Ken-2511/motion-light-switch/slave/motion-light-switch-slave.kicad_pcb

## KiCad design slave/motion-light-switch-slave.kicad_pcb (2026-11-13)

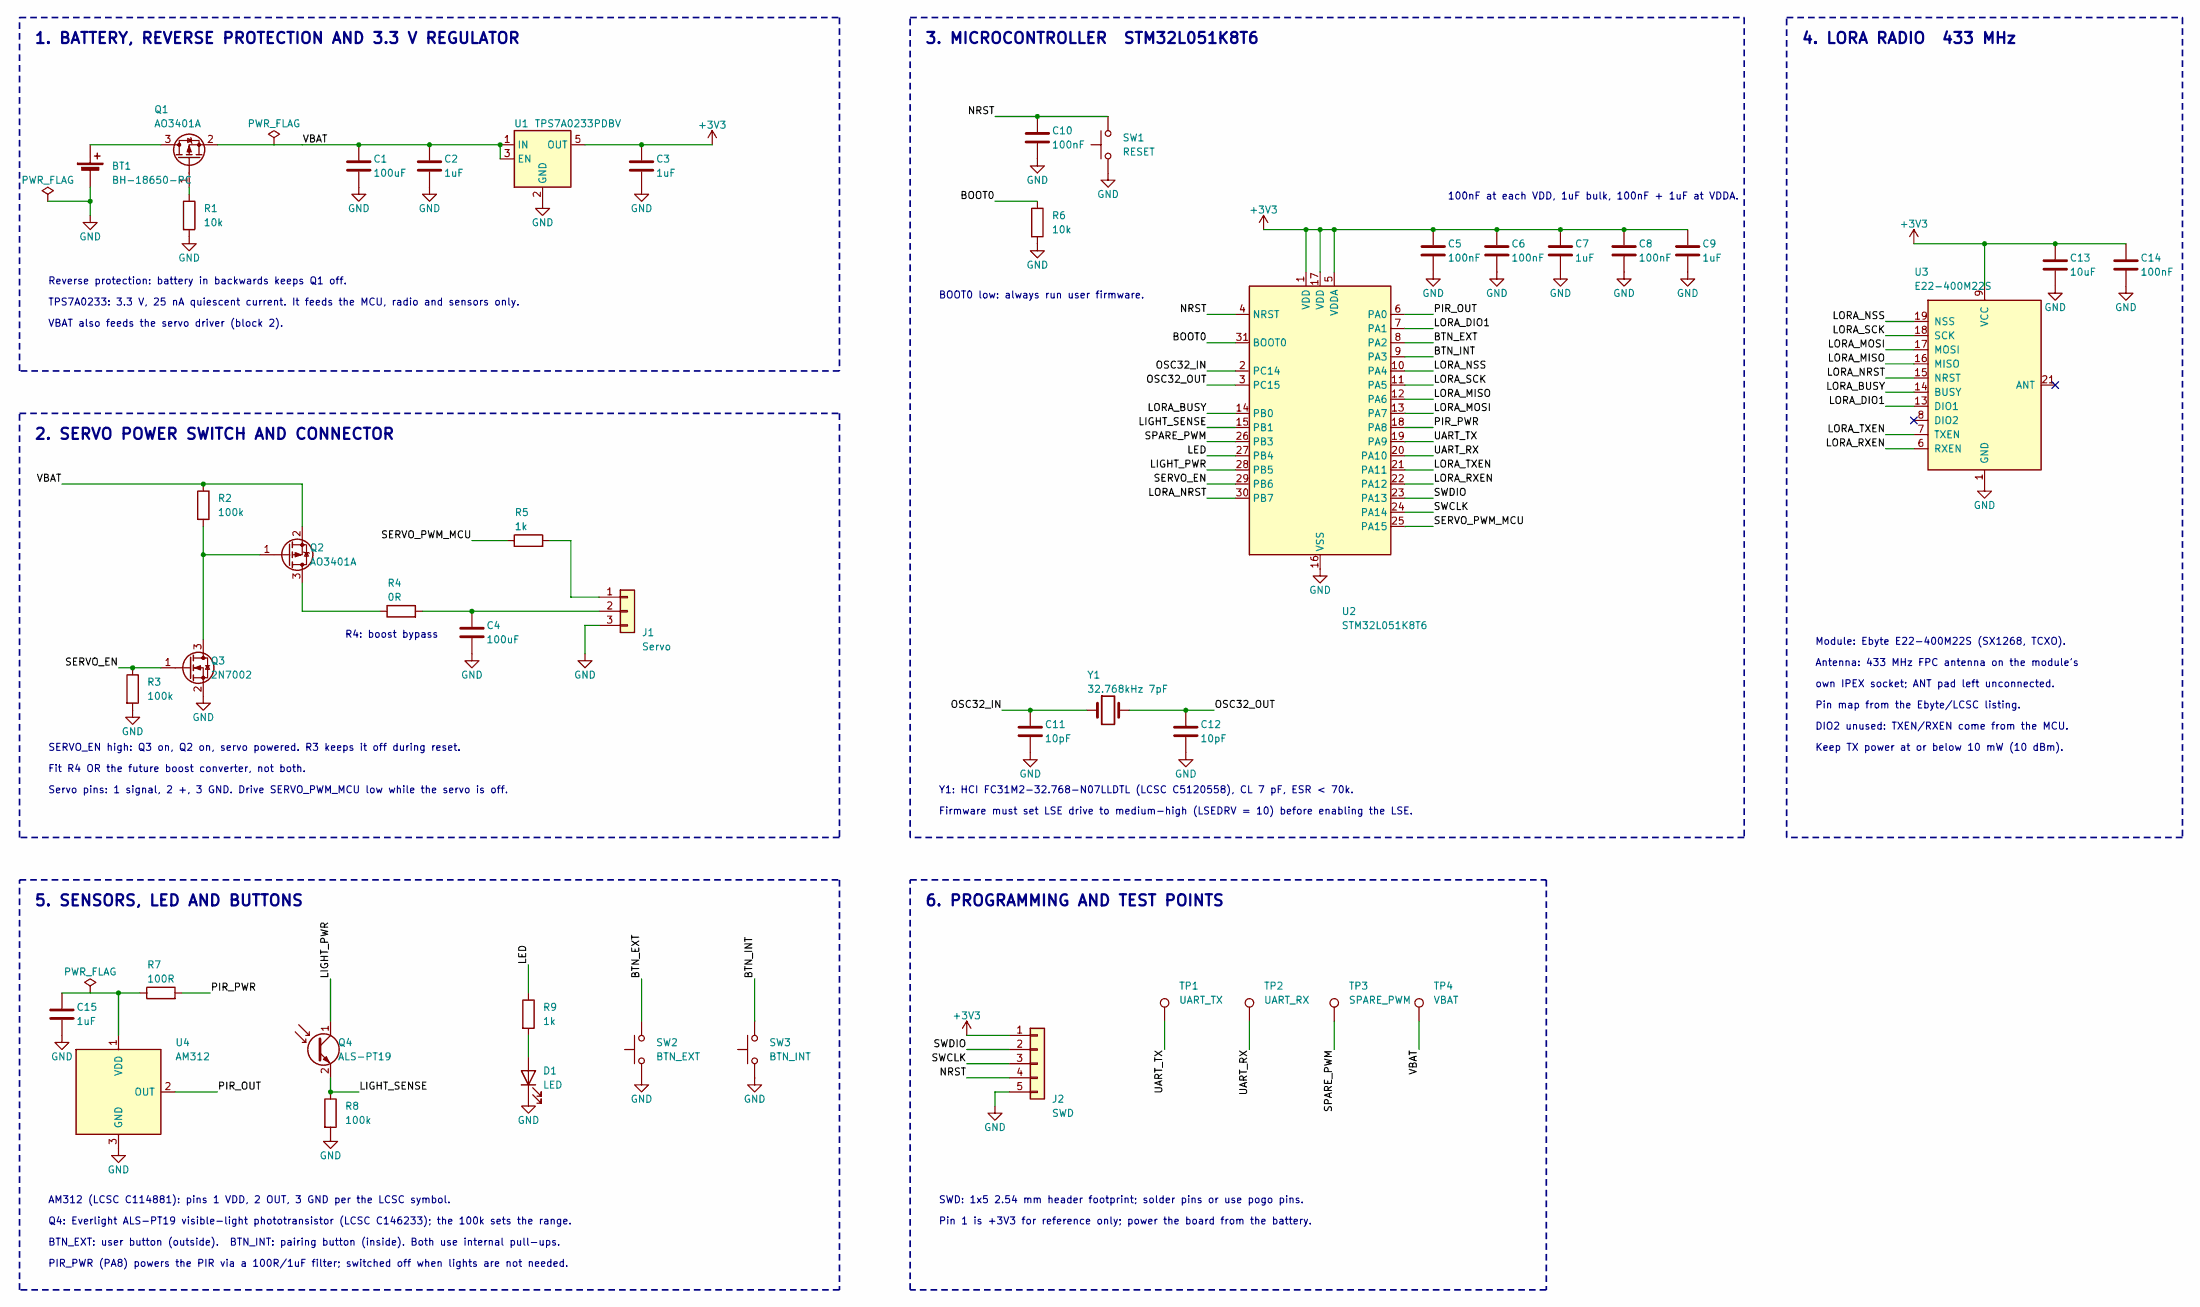
[picture p1: schematic motion-light-switch-slave.kicad_sch, Motion Light Switch - Slave]

Parts:
BT1: BH-18650-PC; BatteryHolder_MPD_BH-18650-PC
C1, C4: 100uF; C_1206_3216Metric
C2, C3, C7, C9, C15: 1uF; C_0603_1608Metric
C5, C6, C8, C10, C14: 100nF; C_0603_1608Metric
C11, C12: 10pF; C_0603_1608Metric
C13: 10uF; C_0805_2012Metric
D1: LED; LED_0603_1608Metric
J1: Servo; PinHeader_1x03_P2.54mm_Vertical
J2: SWD; PinHeader_1x05_P2.54mm_Vertical
Q1, Q2: AO3401A; SOT-23
Q3: 2N7002; SOT-23
Q4: ALS-PT19
R1, R6: 10k; R_0603_1608Metric
R2, R3, R8: 100k; R_0603_1608Metric
R4: 0R; R_0603_1608Metric
R5, R9: 1k; R_0603_1608Metric
R7: 100R; R_0603_1608Metric
SW1: RESET; SW_SPST_TL3342
SW2: BTN_EXT; SW_SPST_TL3342
SW3: BTN_INT; SW_SPST_TL3342
TP1: UART_TX; TestPoint_Pad_D1.0mm
TP2: UART_RX; TestPoint_Pad_D1.0mm
TP3: SPARE_PWM; TestPoint_Pad_D1.0mm
TP4: VBAT; TestPoint_Pad_D1.0mm
U1: TPS7A0233PDBV; SOT-23-5
U2: STM32L051K8T6; LQFP-32_7x7mm_P0.8mm
U3: E22-400M22S
U4: AM312; AM312_TO-5-3
Y1: 32.768kHz 7pF; Crystal_SMD_3215-2Pin_3.2x1.5mm

Connections:
+3V3: C3.1, C5.1, C6.1, C7.1, C8.1, C9.1, C13.1, C14.1, J2.1, U1.5 (OUT), U2.1 (VDD), U2.5 (VDDA), U2.17 (VDD), U3.9 (VCC)
/BOOT0: R6.1, U2.31 (BOOT0)
/BTN_EXT: SW2.2, U2.8 (PA2)
/BTN_INT: SW3.2, U2.9 (PA3)
/LED: R9.1, U2.27 (PB4)
/LIGHT_PWR: Q4.1 (C), U2.28 (PB5)
/LIGHT_SENSE: Q4.2 (E), R8.1, U2.15 (PB1)
/LORA_BUSY: U2.14 (PB0), U3.14 (BUSY)
/LORA_DIO1: U2.7 (PA1), U3.13 (DIO1)
/LORA_MISO: U2.12 (PA6), U3.16 (MISO)
/LORA_MOSI: U2.13 (PA7), U3.17 (MOSI)
/LORA_NRST: U2.30 (PB7), U3.15 (NRST)
/LORA_NSS: U2.10 (PA4), U3.19 (NSS)
/LORA_RXEN: U2.22 (PA12), U3.6 (RXEN)
/LORA_SCK: U2.11 (PA5), U3.18 (SCK)
/LORA_TXEN: U2.21 (PA11), U3.7 (TXEN)
/NRST: C10.1, J2.4, SW1.2, U2.4 (NRST)
/OSC32_IN: C11.1, U2.2 (PC14), Y1.1
/OSC32_OUT: C12.1, U2.3 (PC15), Y1.2
/PIR_OUT: U2.6 (PA0), U4.2 (OUT)
/PIR_PWR: R7.2, U2.18 (PA8)
/SERVO_EN: Q3.1 (G), R3.1, U2.29 (PB6)
/SERVO_PWM_MCU: R5.1, U2.25 (PA15)
/SPARE_PWM: TP3.1, U2.26 (PB3)
/SWCLK: J2.3, U2.24 (PA14)
/SWDIO: J2.2, U2.23 (PA13)
/UART_RX: TP2.1, U2.20 (PA10)
/UART_TX: TP1.1, U2.19 (PA9)
/VBAT: C1.1, C2.1, Q1.2 (S), Q2.2 (S), R2.1, TP4.1, U1.1 (IN), U1.3 (EN)
GND: BT1.2 (-), C1.2, C2.2, C3.2, C4.2, C5.2, C6.2, C7.2, C8.2, C9.2, C10.2, C11.2, C12.2, C13.2, C14.2, C15.2, D1.1 (K), J1.3, J2.5, Q3.2 (S), R1.2, R3.2, R6.2, R8.2, SW1.1, SW2.1, SW3.1, U1.2 (GND), U2.16 (VSS), U2.32 (VSS), U3.1 (GND), U3.2 (GND), U3.3 (GND), U3.4 (GND), U3.5 (GND), U3.10 (GND), U3.11 (GND), U3.12 (GND), U3.20 (GND), U3.22 (GND), U4.3 (GND)
unnamed: BT1.1 (+), Q1.3 (D)
unnamed: D1.2 (A), R9.2
unnamed: J1.1, R5.2
unnamed: C4.1, J1.2, R4.2
unnamed: Q1.1 (G), R1.1
unnamed: Q2.3 (D), R4.1
unnamed: Q2.1 (G), Q3.3 (D), R2.2
unnamed: C15.1, R7.1, U4.1 (VDD)

Notes on the sheet:
1. BATTERY, REVERSE PROTECTION AND 3.3 V REGULATOR
Reverse protection: battery in backwards keeps Q1 off.
TPS7A0233: 3.3 V, 25 nA quiescent current. It feeds the MCU, radio and sensors only.
VBAT also feeds the servo driver (block 2).
2. SERVO POWER SWITCH AND CONNECTOR
R4: boost bypass
SERVO_EN high: Q3 on, Q2 on, servo powered. R3 keeps it off during reset.
Fit R4 OR the future boost converter, not both.
Servo pins: 1 signal, 2 +, 3 GND. Drive SERVO_PWM_MCU low while the servo is off.
3. MICROCONTROLLER STM32L051K8T6
100nF at each VDD, 1uF bulk, 100nF + 1uF at VDDA.
BOOT0 low: always run user firmware.
Y1: HCI FC31M2-32.768-N07LLDTL (LCSC C5120558), CL 7 pF, ESR < 70k.
Firmware must set LSE drive to medium-high (LSEDRV = 10) before enabling the LSE.
4. LORA RADIO 433 MHz
Module: Ebyte E22-400M22S (SX1268, TCXO).
Antenna: 433 MHz FPC antenna on the module's
own IPEX socket; ANT pad left unconnected.
Pin map from the Ebyte/LCSC listing.
DIO2 unused: TXEN/RXEN come from the MCU.
Keep TX power at or below 10 mW (10 dBm).
5. SENSORS, LED AND BUTTONS
AM312 (LCSC C114881): pins 1 VDD, 2 OUT, 3 GND per the LCSC symbol.
Q4: Everlight ALS-PT19 visible-light phototransistor (LCSC C146233); the 100k sets the range.
BTN_EXT: user button (outside). BTN_INT: pairing button (inside). Both use internal pull-ups.
PIR_PWR (PA8) powers the PIR via a 100R/1uF filter; switched off when lights are not needed.
6. PROGRAMMING AND TEST POINTS
SWD: 1x5 2.54 mm header footprint; solder pins or use pogo pins.
Pin 1 is +3V3 for reference only; power the board from the battery.

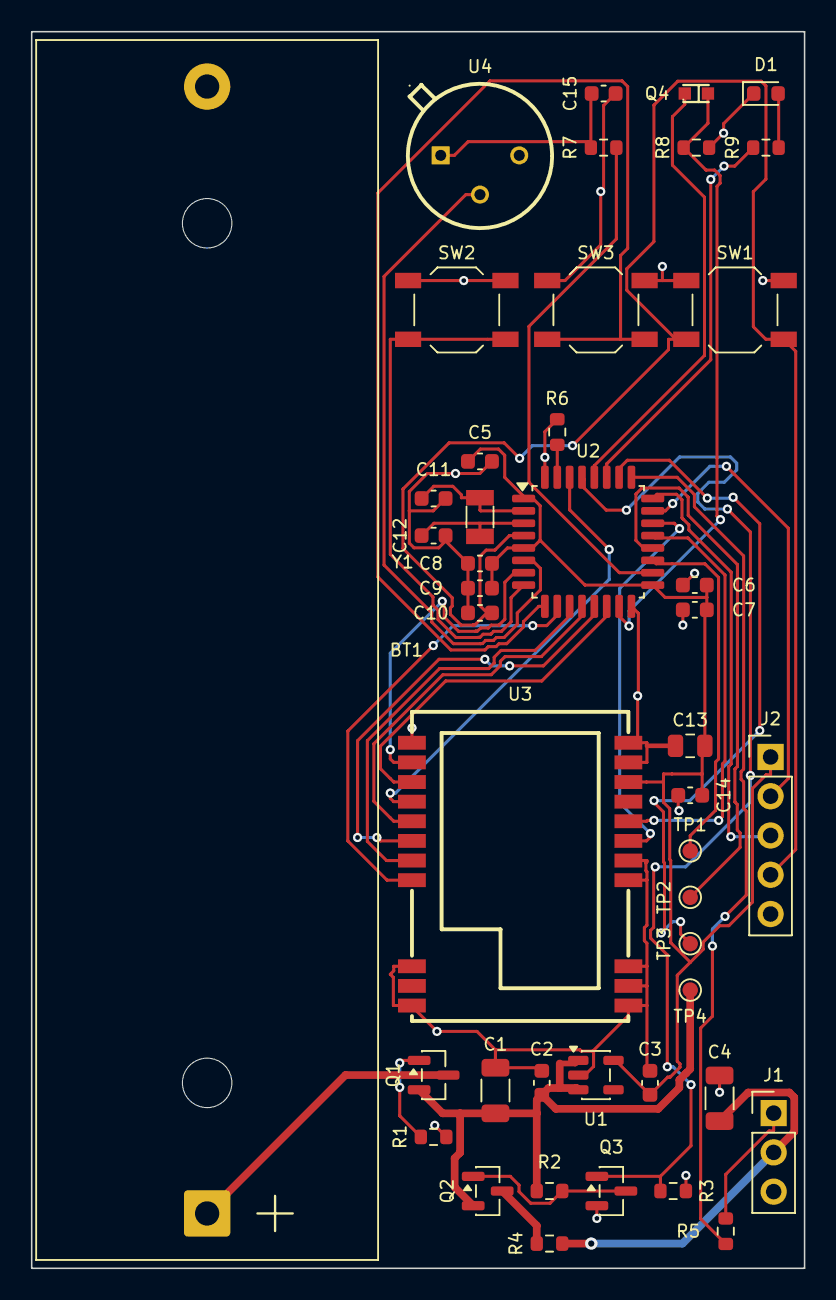
[picture p2: board motion-light-switch-slave.kicad_pcb from above]

Board: 2 copper layers, 50.0 x 80.0 mm, 44 parts (0 on the bottom side), 38 nets.
