Ken-2511/motion-light-switch/master/motion-light-switch-master.kicad_pcb

## KiCad design master/motion-light-switch-master.kicad_pcb (2026-11-13)

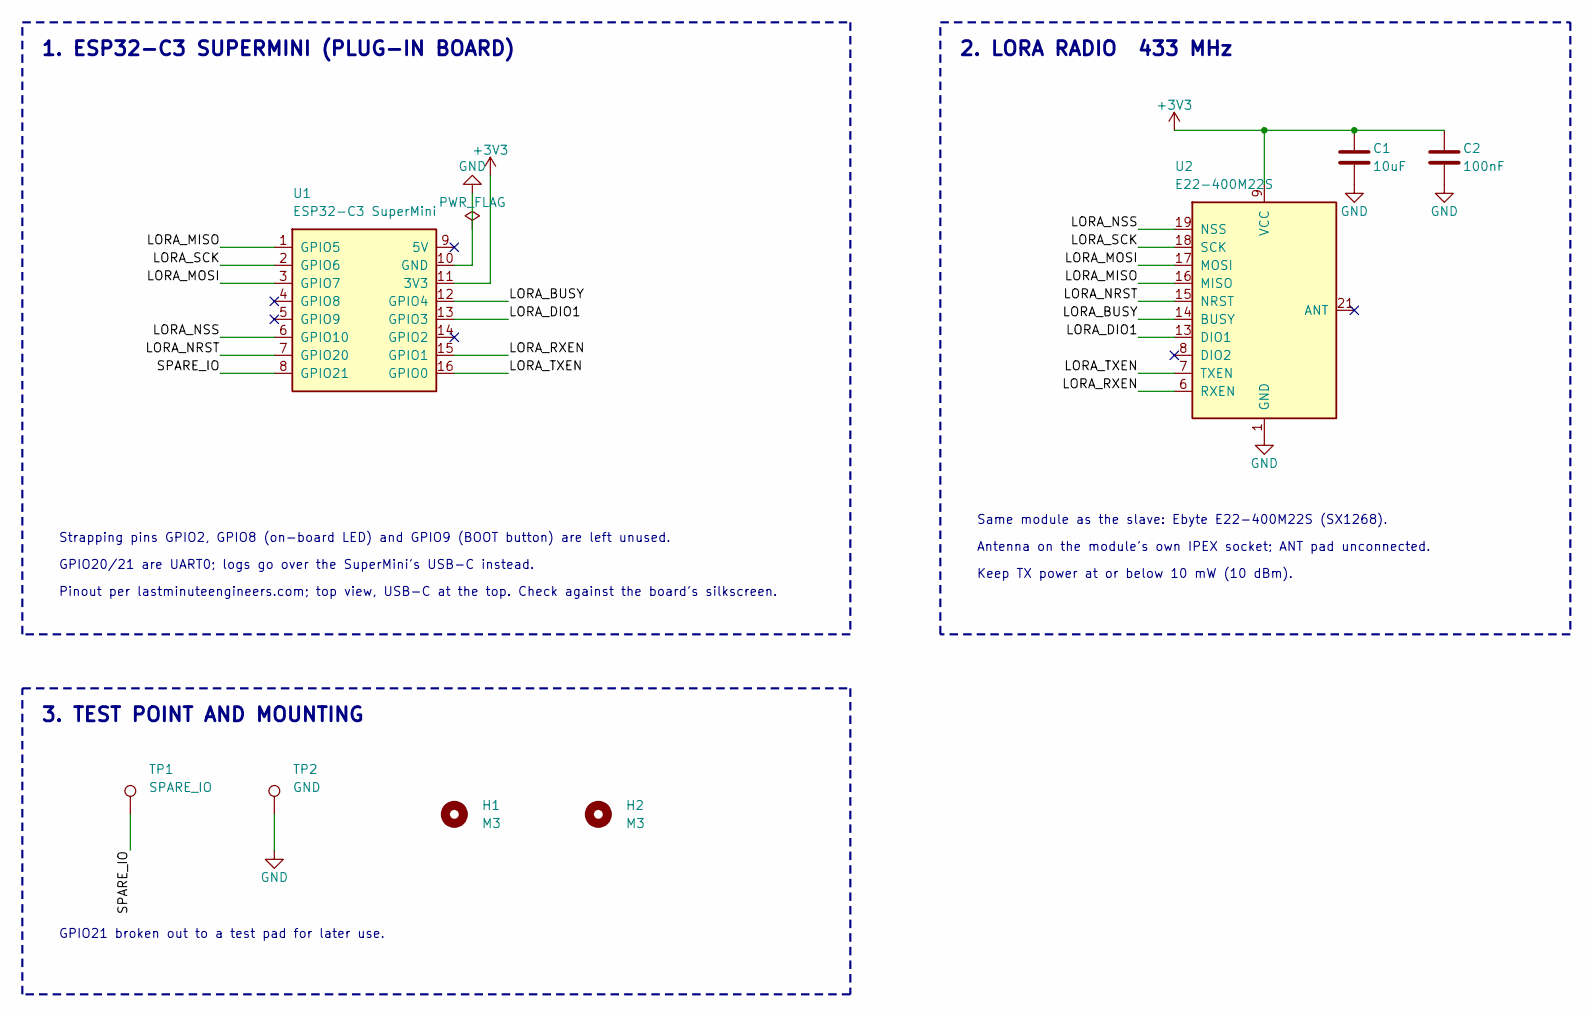
[picture p3: schematic motion-light-switch-master.kicad_sch, Motion Light Switch - Master]

Parts:
C1: 10uF; C_0805_2012Metric
C2: 100nF; C_0603_1608Metric
H1, H2: M3; MountingHole_3.2mm_M3
TP1: SPARE_IO; TestPoint_Pad_D1.0mm
TP2: GND; TestPoint_Pad_D1.0mm
U1: ESP32-C3 SuperMini; ESP32-C3_SuperMini_Socket
U2: E22-400M22S

Connections:
+3V3: C1.1, C2.1, U1.11 (3V3), U2.9 (VCC)
/LORA_BUSY: U1.12 (GPIO4), U2.14 (BUSY)
/LORA_DIO1: U1.13 (GPIO3), U2.13 (DIO1)
/LORA_MISO: U1.1 (GPIO5), U2.16 (MISO)
/LORA_MOSI: U1.3 (GPIO7), U2.17 (MOSI)
/LORA_NRST: U1.7 (GPIO20), U2.15 (NRST)
/LORA_NSS: U1.6 (GPIO10), U2.19 (NSS)
/LORA_RXEN: U1.15 (GPIO1), U2.6 (RXEN)
/LORA_SCK: U1.2 (GPIO6), U2.18 (SCK)
/LORA_TXEN: U1.16 (GPIO0), U2.7 (TXEN)
/SPARE_IO: TP1.1, U1.8 (GPIO21)
GND: C1.2, C2.2, TP2.1, U1.10 (GND), U2.1 (GND), U2.2 (GND), U2.3 (GND), U2.4 (GND), U2.5 (GND), U2.10 (GND), U2.11 (GND), U2.12 (GND), U2.20 (GND), U2.22 (GND)

Notes on the sheet:
1. ESP32-C3 SUPERMINI (PLUG-IN BOARD)
Strapping pins GPIO2, GPIO8 (on-board LED) and GPIO9 (BOOT button) are left unused.
GPIO20/21 are UART0; logs go over the SuperMini's USB-C instead.
Pinout per lastminuteengineers.com; top view, USB-C at the top. Check against the board's silkscreen.
2. LORA RADIO 433 MHz
Same module as the slave: Ebyte E22-400M22S (SX1268).
Antenna on the module's own IPEX socket; ANT pad unconnected.
Keep TX power at or below 10 mW (10 dBm).
3. TEST POINT AND MOUNTING
GPIO21 broken out to a test pad for later use.

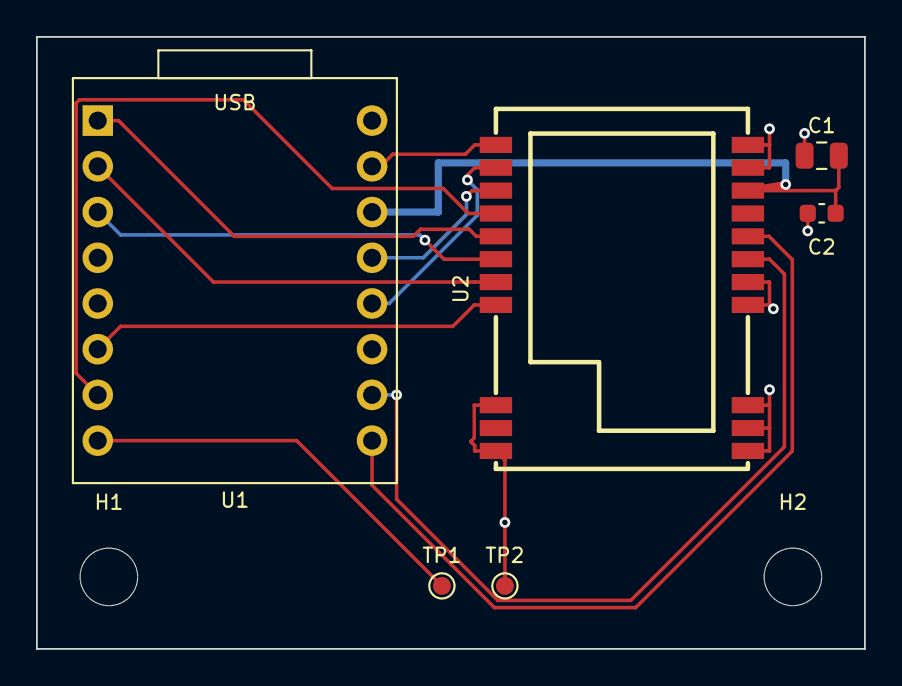
[picture p4: board motion-light-switch-master.kicad_pcb from above]

Board: 2 copper layers, 46.0 x 34.0 mm, 8 parts (0 on the bottom side), 12 nets.
