Ken-2511/motion-light-switch/(commit log)

2026-11-09 Record MCU, radio and LoRa band decisions in README
    Slave: STM32L051 with a 433 MHz SX1268 module. Master: ESP32-C3
    SuperMini hand-wired to a 433 MHz SX1268 module. Plain LoRa with
    SX1268 duty-cycled listening (~1 s) so the master can reach any
    slave. Drop suggestions that only applied to an ESP32 slave.
2026-11-09 Add KiCad project files
    [motion-light-switch.kicad_pcb, motion-light-switch.kicad_sch]
2026-11-09 Stop tracking KiCad local settings file and add .gitignore
2026-11-09 Record slave power, sensor and pin decisions; restructure README
    Add the AM312 PIR, phototransistor, TPS7A0233 LDO, AO3401
    reverse-polarity protection, servo power switch, VREFINT battery
    monitoring, and the STM32L051K8T6 pin assignment checked against the
    datasheet. Merge duplicate sections, drop resolved questions and
    suggestions, and redo the battery estimate for the STM32L0 design.
2026-11-12 Draw slave schematic; add crystal and switchable PIR power
    Slave schematic in six wired blocks (power, servo switch, MCU, LoRa
    radio, sensors, programming), ERC clean. Project symbol library adds
    E22-400M22S, AM312 and TPS7A0233PDBV. Fit the HCI FC31M2 32.768 kHz
    crystal (medium-high LSE drive) and power the PIR from PA8 through a
    100R/1uF filter. README updated to match.
    [motion-light-switch.kicad_sch]
2026-11-12 Use the E22-400M22S's own IPEX antenna socket
    Remove the separate antenna connector from the slave schematic and
    leave the module's ANT pad unconnected. README names the
    E22-400M22S for both master and slave.
    [motion-light-switch.kicad_sch]
2026-11-12 Assign footprints to all slave parts
    Add a project footprint library with E22-400M22S, AM312 (TO-5) and
    ALS-PT19 footprints converted from LCSC data. Use 2.54 mm headers for
    the servo and SWD connectors and the MPD BH-18650-PC footprint for
    the Taobao 18650 holder. Choose the visible-light ALS-PT19 for
    ambient light. README updated to match.
    [motion-light-switch.kicad_sch]
2026-11-13 Place and autoroute the slave PCB
    50x80 mm two-layer board: 18650 holder along the left edge, all parts
    on the front, GND pour on the back. Routed with Freerouting 2.5.0;
    0.5 mm Power net class for the battery/servo path, keep-out under the
    E22-400M22S, edge clearance 0.3 mm. DRC clean except cosmetic
    warnings. Also fix the AM312 courtyard and exclude test points from
    the BOM.
    [motion-light-switch.kicad_pcb, motion-light-switch.kicad_sch]
2026-11-13 Re-place and reroute the slave PCB for a solid ground plane
    Move the radio module next to the MCU and the regulator/servo switch
    next to the battery + terminal; put each decoupling capacitor at its
    pin and the crystal at PC14/PC15. Autoroute with high back-layer and
    via costs so B.Cu stays an almost unbroken GND pour, hand-route the
    servo supply link, and set the pour clearance to 0.2 mm. DRC clean
    apart from silkscreen warnings.
    [motion-light-switch.kicad_pcb]
2026-11-13 Tidy slave PCB silkscreen labels
    Shrink reference labels to 0.8 mm and place each one clear of pads,
    other silkscreen and other labels. Only the ALS-PT19 footprint's own
    outline still touches its pad.
    [motion-light-switch.kicad_pcb]
2026-11-13 Add master carrier board project
    New KiCad project in master/: ESP32-C3 SuperMini on two 1x8 sockets
    plus an E22-400M22S on a 46x34 mm board with two M3 holes. Radio on
    GPIO6/7/5 (SPI), GPIO10 NSS, GPIO4 BUSY, GPIO3 DIO1, GPIO20 NRST,
    GPIO0/1 TXEN/RXEN; strapping pins unused, GPIO21 on a test pad.
    Shared libraries gain a SuperMini symbol and socket footprint. ERC
    and DRC clean.
    [motion-light-switch-master.kicad_pcb, motion-light-switch-master.kicad_sch]
2026-11-13 Reorganize into slave/, master/ and lib/ folders
    Move the slave KiCad project into slave/ (renamed
    motion-light-switch-slave), keep the master in master/, and move the
    shared symbol and footprint library into lib/. Both projects' library
    tables point to ../lib. README gains a folder-layout table, the master
    carrier board and its ESP32-C3 pin assignment.
    [motion-light-switch-slave.kicad_pcb, motion-light-switch-slave.kicad_sch]
2026-11-13 Add JLCPCB Gerber and drill files for both boards
    production/ holds the exported Gerbers (9 layers) and plated/unplated
    drill files for the slave (50x80 mm) and master (46x34 mm) boards, plus
    one upload zip per board. KiCad also recorded the slave's top-level
    sheet in its project file.
    [motion-light-switch-master-B_Cu.gbl, motion-light-switch-master-B_Mask.gbs, motion-light-switch-master-B_Paste.gbp, motion-light-switch-master-B_Silkscreen.gbo, motion-light-switch-master-Edge_Cuts.gm1, motion-light-switch-master-F_Cu.gtl, motion-light-switch-master-F_Mask.gts, motion-light-switch-master-F_Paste.gtp]
2026-11-13 README: choose MG90S and straight-bar press mechanism
    Record the estimated 86-type rocker size, the straight bar on the servo
    shaft at pivot height with an optional 1:3 gear pair, and correct the
    servo supply row: the slave PCB has no boost converter footprint.
